egarris2/Cylon/(list of files, drawings)

Other design files:
Hardware/Cylon/PCB_Cylon_BRD_2023-02-24.json
Hardware/Cylon/SCH_Cylon_2023-02-24.json
