egarris2/Cylon/(commit log)

2023-02-24 Added Caprica Firmware for setting up webserver and flashing leds by pressing buttons on web page.
    [PCB_Cylon_BRD_2023-02-24.json, SCH_Cylon_2023-02-24.json]
2023-02-24 Added QuickStart guide
    [PCB_Cylon_BRD_2023-02-24.json, SCH_Cylon_2023-02-24.json]
